hoapham9501/6dofarmrobot/Bản vẽ 3D/Axis2part1_1.step.SLDASM

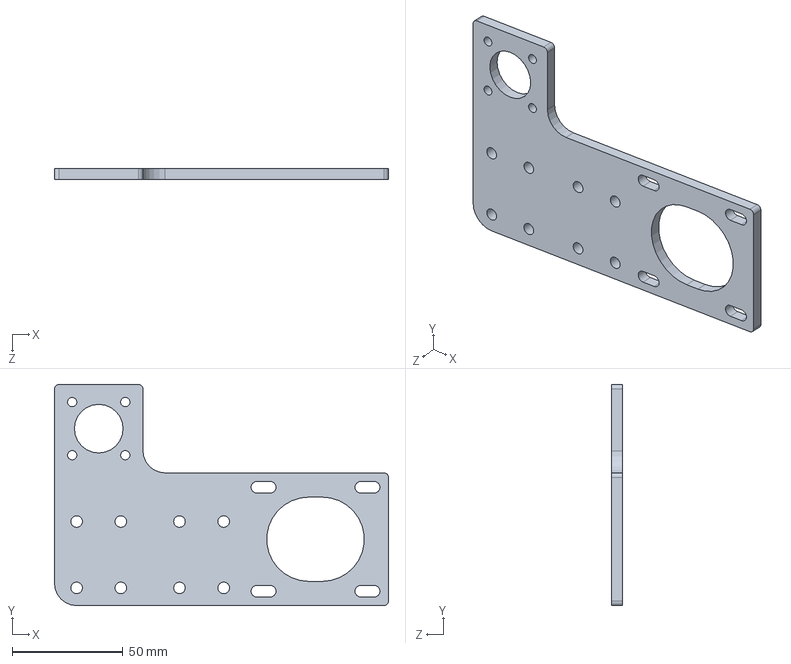
[picture p1: CAD file, 2023-03-05]
Bản vẽ 3D/Axis2part1_1.step.SLDASM
151.0 x 100.0 x 5.00 mm
