hoapham9501/6dofarmrobot/Bản vẽ 3D/4.SLDASM

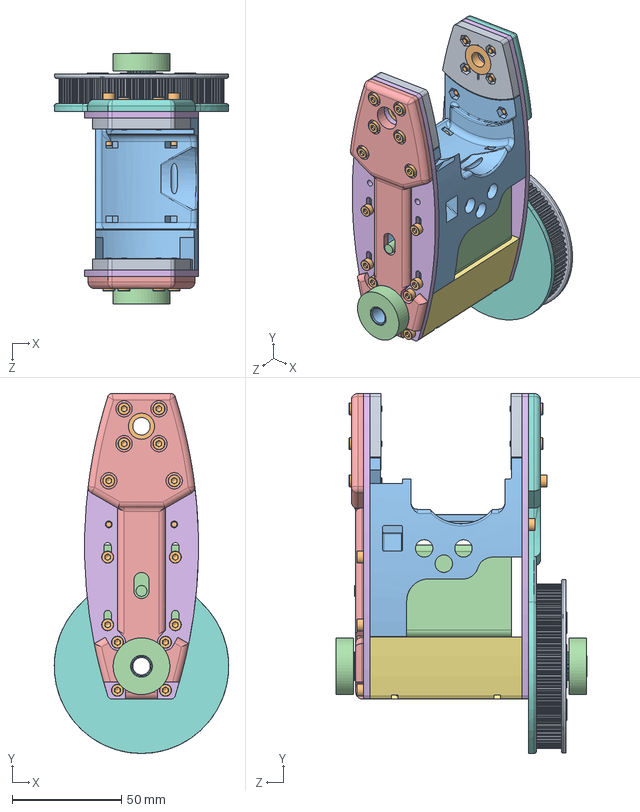
[picture p2: CAD file, 2023-03-05]
Bản vẽ 3D/4.SLDASM
80.0 x 165.0 x 115.0 mm
Axis3bearingHolder.step x 2
Bearing16_8_5_1.step x 2
Axis3part2.step
Nema17_1.step
Axis3cover1.step
Axis3part1_2.step x 2
Axis3part3.step
Axis3cover2.step
Axis2Pulley_1.step
socket head cap screw_iso x 27
Axis2tube.step
Bearing26_10_8_2.step x 2
