hoapham9501/6dofarmrobot/Bản vẽ 3D/Axis3part2.step.SLDPRT

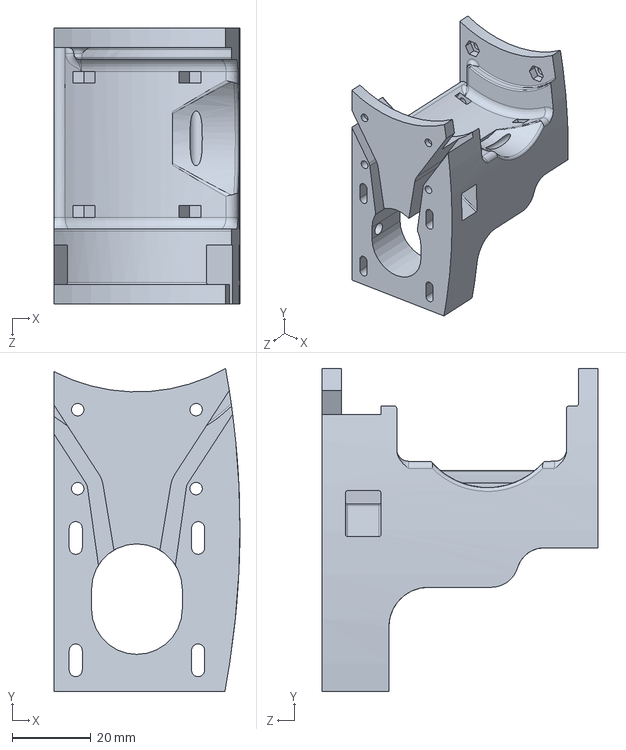
[picture p3: CAD file, 2023-03-05]
Bản vẽ 3D/Axis3part2.step.SLDPRT
47.1 x 81.8 x 69.8 mm
