hoapham9501/6dofarmrobot/Bản vẽ 3D/GT2 20B5.SLDPRT

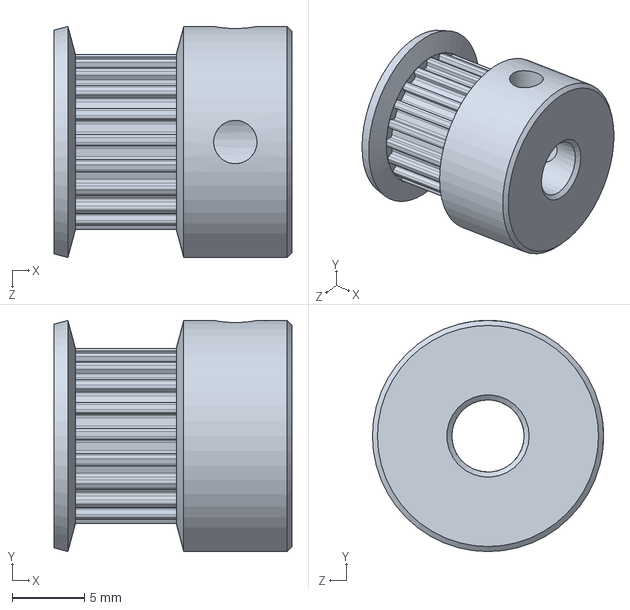
[picture p4: CAD file, 2023-03-05]
Bản vẽ 3D/GT2 20B5.SLDPRT
16.5 x 16.0 x 16.0 mm
