hoapham9501/6dofarmrobot/Bản vẽ 3D/Axis1part2_1.step.SLDPRT

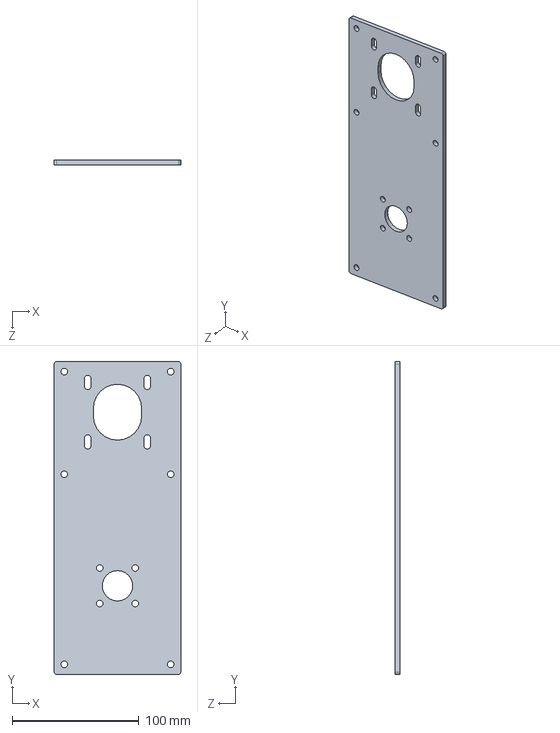
[picture p5: CAD file, 2023-03-05]
Bản vẽ 3D/Axis1part2_1.step.SLDPRT
100.0 x 247.0 x 4.00 mm
