hoapham9501/6dofarmrobot/Bản vẽ 3D/NEMA23(SY57STH56-4004A).SLDPRT

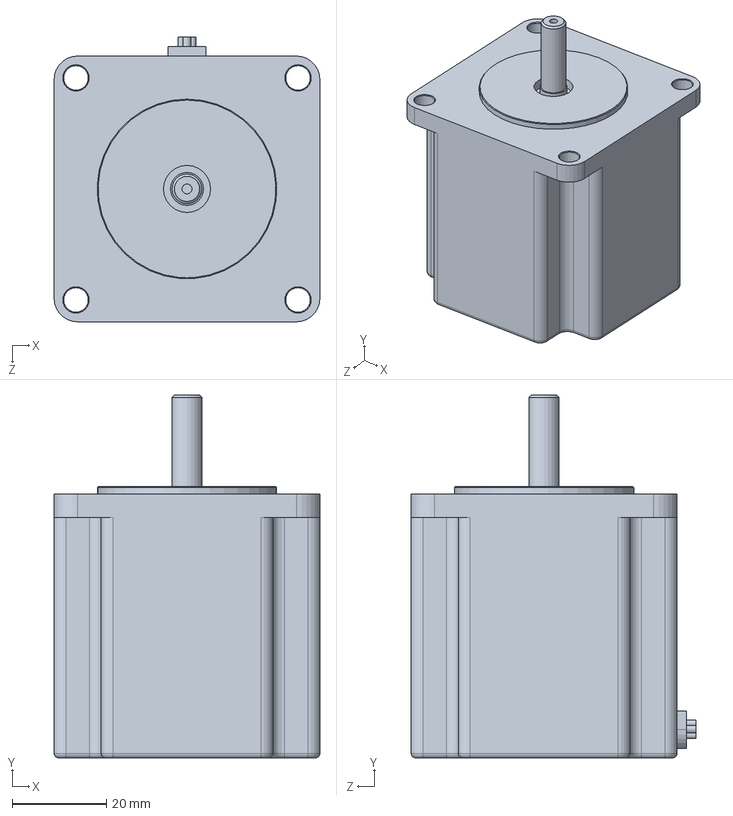
[picture p6: CAD file, 2023-03-05]
Bản vẽ 3D/NEMA23(SY57STH56-4004A).SLDPRT
56.4 x 77.0 x 60.4 mm
