hoapham9501/6dofarmrobot/Bản vẽ 3D/Axis4.step.SLDPRT

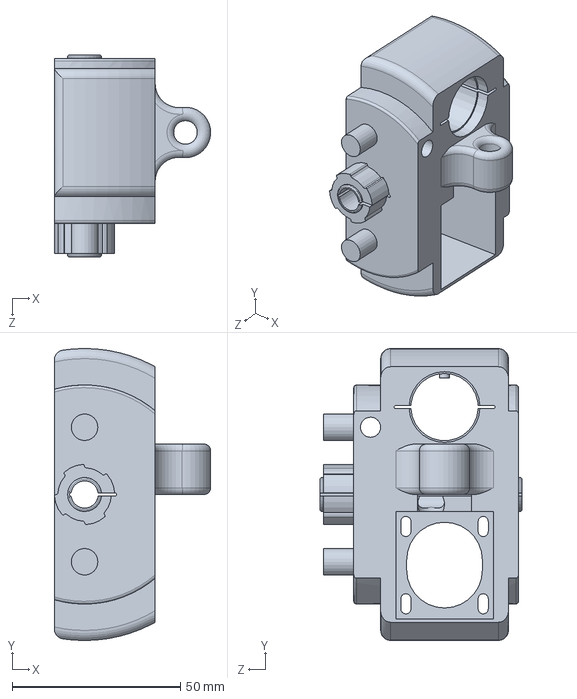
[picture p7: CAD file, 2023-03-05]
Bản vẽ 3D/Axis4.step.SLDPRT
46.5 x 86.8 x 60.0 mm
