hoapham9501/6dofarmrobot/Bản vẽ 3D/HTD3M 20T BORE 8MM.SLDPRT

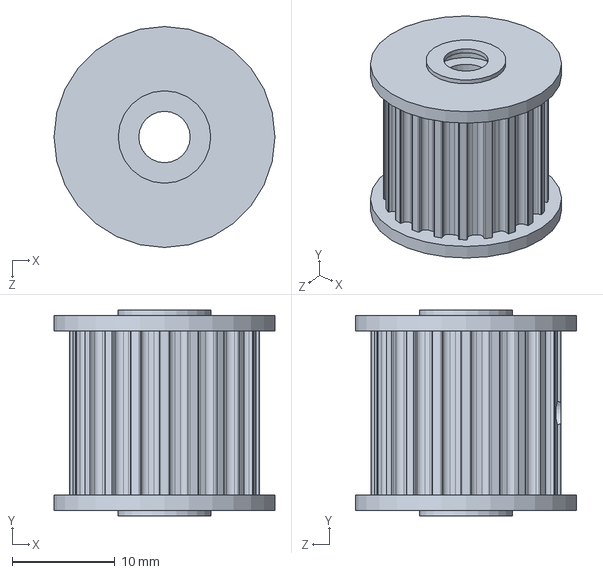
[picture p8: CAD file, 2023-03-05]
Bản vẽ 3D/HTD3M 20T BORE 8MM.SLDPRT
21.5 x 20.0 x 21.5 mm
