hoapham9501/6dofarmrobot/Bản vẽ 3D/Axis5_1.step.SLDPRT

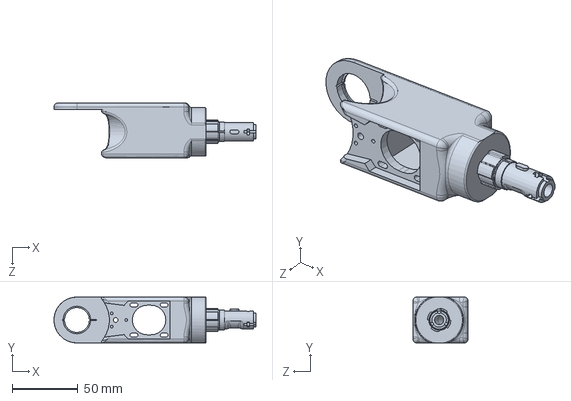
[picture p9: CAD file, 2023-03-05]
Bản vẽ 3D/Axis5_1.step.SLDPRT
154.0 x 35.0 x 42.0 mm
