hoapham9501/6dofarmrobot/Bản vẽ 3D/Axis5Bracket.step.SLDPRT

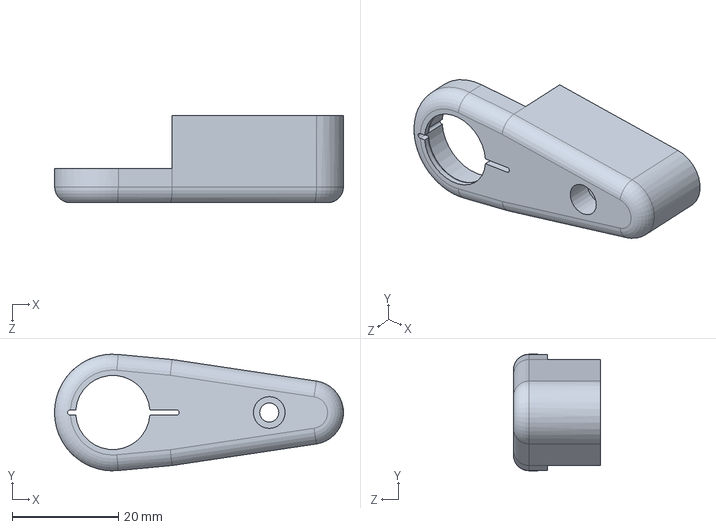
[picture p10: CAD file, 2023-03-05]
Bản vẽ 3D/Axis5Bracket.step.SLDPRT
54.5 x 22.0 x 16.5 mm
