hoapham9501/6dofarmrobot/(list of files, cad)

Other CAD files:
Bản vẽ 3D/Bearing28_12_8_1.step.SLDASM
Bản vẽ 3D/Nema23_1.step.SLDASM
Bản vẽ 3D/Bearing26_10_8_1.step.SLDASM
Bản vẽ 3D/Bearing16_8_5.step-1.SLDASM
Bản vẽ 3D/Nema11_1.step.SLDASM
Bản vẽ 3D/M5standoff_4.step.SLDASM
Bản vẽ 3D/Axis3part1_1.step.SLDASM
Bản vẽ 3D/Nema23.step.SLDASM
Bản vẽ 3D/M5standoff_3.step.SLDASM
Bản vẽ 3D/Bearing28_12_8.step.SLDASM
Bản vẽ 3D/M5standoff_5.step.SLDASM
Bản vẽ 3D/M5standoff_2.step.SLDASM
Bản vẽ 3D/Bearing21_15_4_1.step.SLDASM
Bản vẽ 3D/ThrustBearing28_15_9_1.step.SLDASM
sơ đồ động.dwg
Bản vẽ 3D/Pulley42.step.SLDPRT
Tổng hợp bản vẽ CAD.dwg
Bản vẽ 3D/Axis3part1_2.step.SLDPRT
Bản vẽ 3D/Bearing16_8_5_1.step.SLDPRT
Bản vẽ 3D/Axis1MotorHolderOp.step.SLDPRT
Bản vẽ 3D/Nema23_2.step.SLDPRT
Bản vẽ 3D/Axis2tube.step.SLDPRT
Bản vẽ 3D/Axis5plug.step.SLDPRT
Bản vẽ 3D/Axis2part1_2.step.SLDPRT
Bản vẽ 3D/Axis3tube.step.SLDPRT
Bản vẽ 3D/Pulley56.step.SLDPRT
Bản vẽ 3D/Axis2MotorOpC.step.SLDPRT
Bản vẽ 3D/Pulley100.step.SLDPRT
Bản vẽ 3D/axis6motorHolder_1.step.SLDPRT
Bản vẽ 3D/Axis2part2.step.SLDPRT
Bản vẽ 3D/Axis2Pulley_1.step.SLDPRT
Bản vẽ 3D/M5standoff_6.step.SLDPRT
Bản vẽ 3D/Nema11_2.step.SLDPRT
Bản vẽ 3D/Axis2bearingHC.step.SLDPRT
Bản vẽ 3D/Axis2bearingHolder_1.step.SLDPRT
Bản vẽ 3D/Axis2MotorOp.step.SLDPRT
Bản vẽ 3D/Bearing26_10_8_4.step.SLDPRT
Bản vẽ 3D/Nema17_1.step.SLDPRT
Bản vẽ 3D/Axis1MotorHolder.step.SLDPRT
Bản vẽ 3D/Axis2bearingHolder.step.SLDPRT
Bản vẽ 3D/Axis3cover1.step.SLDPRT
Bản vẽ 3D/Bearing21_15_4_3.step.SLDPRT
Bản vẽ 3D/Bearing26_10_8_2.step.SLDPRT
Bản vẽ 3D/Axis3cover2.step.SLDPRT
Bản vẽ 3D/Axis1Holder.step.SLDPRT
Bản vẽ 3D/Axis1tube.step.SLDPRT
Bản vẽ 3D/Axis3bearingHolder.step.SLDPRT
Bản vẽ 3D/Nema8_1.step.SLDPRT
Bản vẽ 3D/Axis4limit.step.SLDPRT
Bản vẽ 3D/Bearing26_10_8_3.step.SLDPRT
Bản vẽ 3D/Axis1Pulley_1.step.SLDPRT
Bản vẽ 3D/Axis3part3.step.SLDPRT
Bản vẽ 3D/Axis1washer.step.SLDPRT
Bản vẽ 3D/Axis2washer.step.SLDPRT
Bản vẽ 3D/Axis5screwHolder.step.SLDPRT
