hoapham9501/6dofarmrobot/Tổng hợp bản  vẽ.pdf

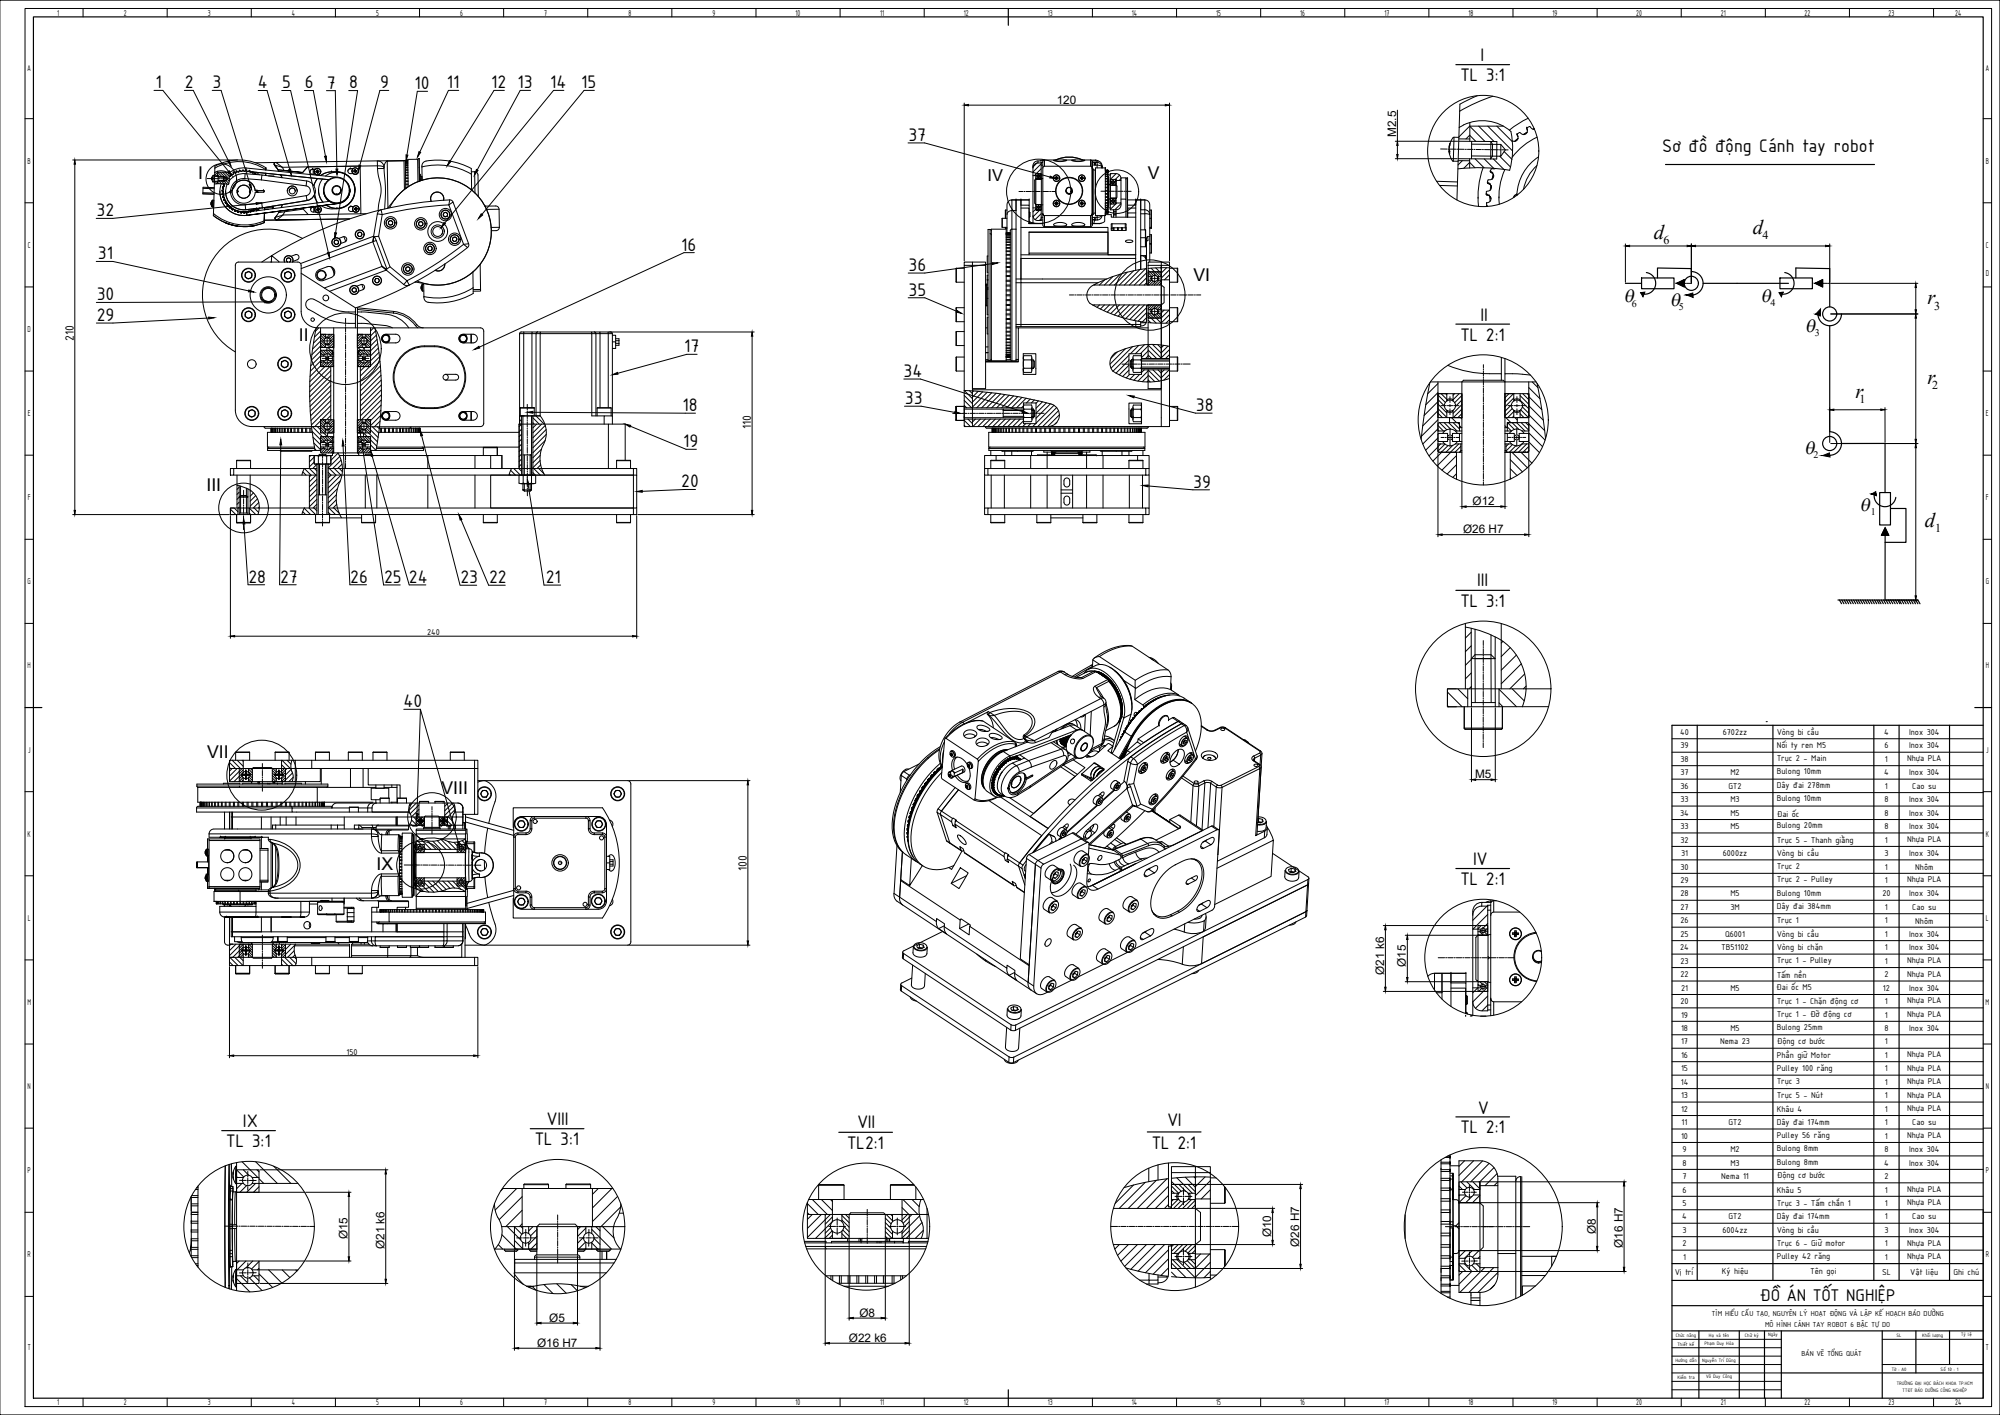
[picture p11: page 1]
24 Thiết kế Hướng dẫn Kiểm tra; Họ và tên Phạm Duy Hòa Nguyễn Trí Dũng Chức năng; Chữ ký; Ngày; BẢN VẼ TỔNG QUÁT; Khối lượng; Số tờ : 1 TRƯỜNG ĐẠI HỌC BÁCH KHOA TP.HCM TTĐT BẢO DƯỠNG CÔNG NGHIỆP 1; A Võ Duy Công Vị trí; Ký hiệu; Tên gọi; Vật liệu; Ghi chú; 1 Dây đai 174mm Pulley 42 răng Trục 6 - Giữ motor Khâu 5 Bulong 8mm Dây đai 174mm Vòng bi cầu Trục 3 Trục 5 - Nút Khâu 4 Pulley 100 răng; 1 Động cơ bước; 8 Trục 1 - Đỡ động cơ; 1 Tấm nền; 2 Trục 1 - Chặn động cơ; 1 Vòng bi chặn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

d6Sơ đồ động Cánh tay robot

Vòng bi cầu | 6 | Nhựa PLA 6702zz Inox 304 40
4 | Inox 304 ĐỒ ÁN TỐT NGHIỆP TÌM HIỂU CẤU TẠO, NGUYÊN LÝ HOẠT ĐỘNG VÀ LẬP KẾ HOẠCH BẢO DƯỠNG MÔ HÌNH CÁNH TAY ROBOT 6 BẬC TỰ DO

Trục 2 - Main | 4 1 Nối ty ren M5 | Inox 304 3839

M5 M3 | Đai ốc M5 Động cơ bước Pulley 56 răng Bulong 10mm Bulong 10mm | 20 12 8 1 M5 1 | Nhựa PLA Nhựa PLA 29 Inox 304 Inox 304 Cao su Nema 23 Inox 304 Nhựa PLA Nhôm Inox 304 TB51102 Inox 304 Q6001 11 Inox 304 Nhôm 36
91012131415161718192021 2324252627283031 3233

2 Bulong 25mm 1

Bulong 8mm | 3 14 | Inox 304 M2

34 | | 1

1 | Nhựa PLA

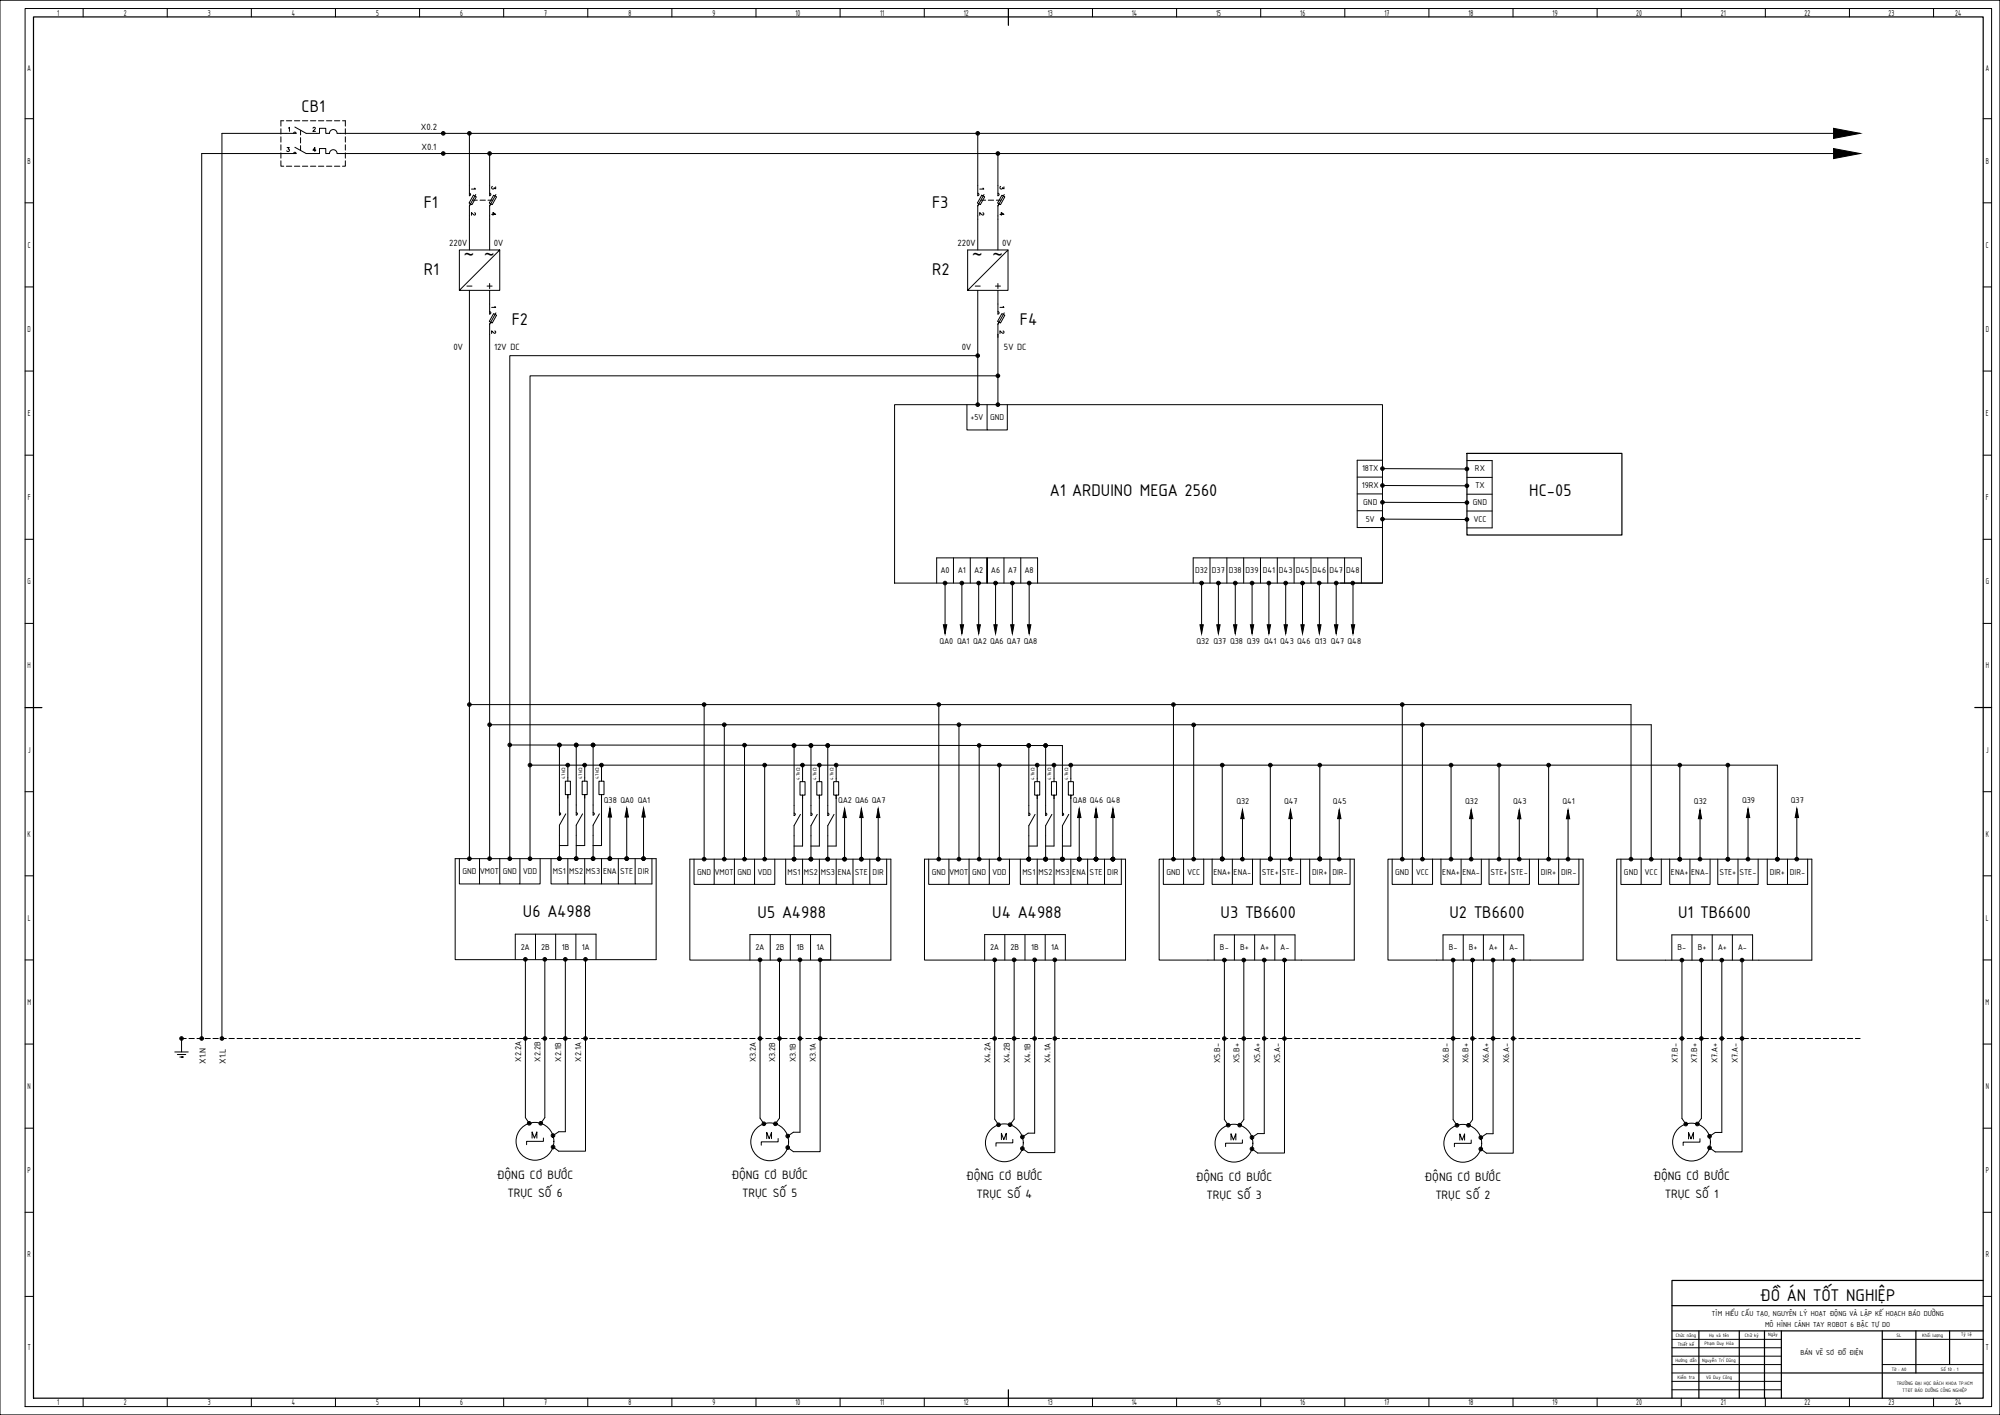
[picture p12: page 2]

X7.A- GND VDD MS1 MS2 MS3 ENA STE DIR U5 A4988 GND VMOT 2A 2B 1B 1A GND VDD MS1 MS2 MS3 ENA STE DIR U4 A4988 GND VMOT 2A 2B 1B 1A ENA+ ENA- U3 TB6600 STE+ STE- DIR+ DIR- B- B+ A+ A- GND VCC QA8 Q46 Q48 CB1 0V 5V DC ~ ~ 220V 0V R1 F1 0V 12V DC

ĐỒ ÁN TỐT NGHIỆP

TÌM HIỂU CẤU TẠO, NGUYÊN LÝ HOẠT ĐỘNG VÀ LẬP KẾ HOẠCH BẢO DƯỠNG

Chức năng | Họ và tên | Chữ ký | Ngày

Phạm Duy Hòa

TRƯỜNG ĐẠI HỌC BÁCH KHOA TP.HCM
TTĐT BẢO DƯỠNG CÔNG NGHIỆP

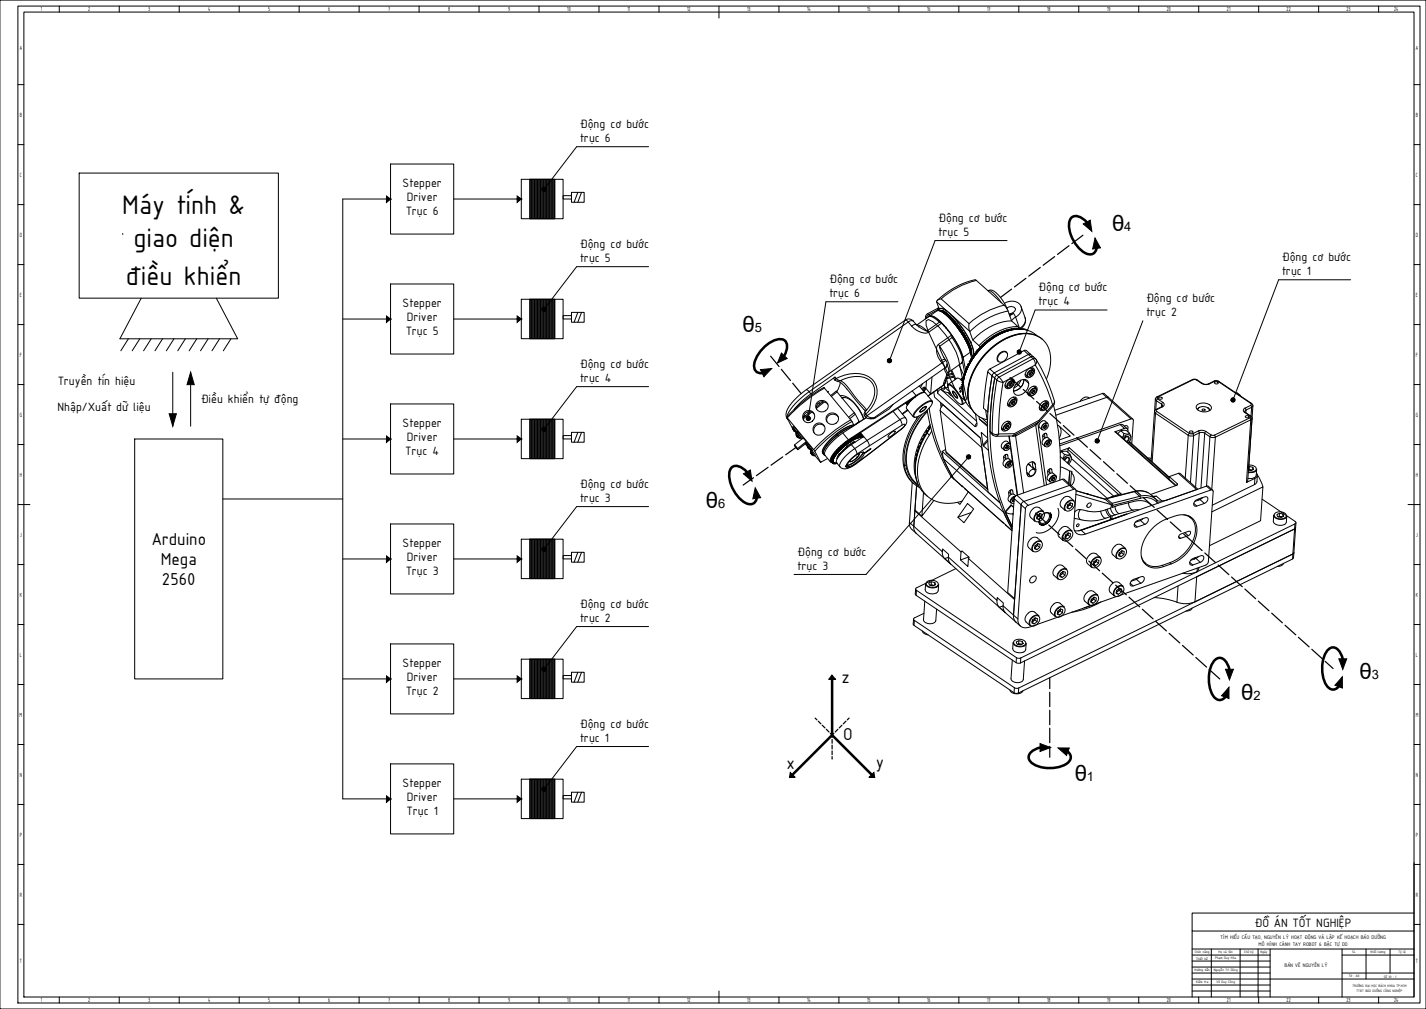
[picture p13: page 3]
24 CDEFGHJKLMNPTRA; BCDEFGHJKLMNPTRA Arduino Mega 2560 Nhập/Xuất dữ liệu; Điều khiển tự động Truyền tín hiệuMáy tính & giao diện điều khiển; θ3 θ4 θ5 θ6 Stepper Driver Trục 6; Động cơ bước trục 6 Stepper Driver Trục 5 Stepper Driver Trục 4 Stepper Driver Trục 3 Stepper Driver Trục 2 Stepper Driver Trục 1; Động cơ bước trục 5 Động cơ bước trục 4; Động cơ bước trục 3 Động cơ bước trục 2 Động cơ bước trục 1; Động cơ bước trục 6; Động cơ bước trục 5; Động cơ bước trục 4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

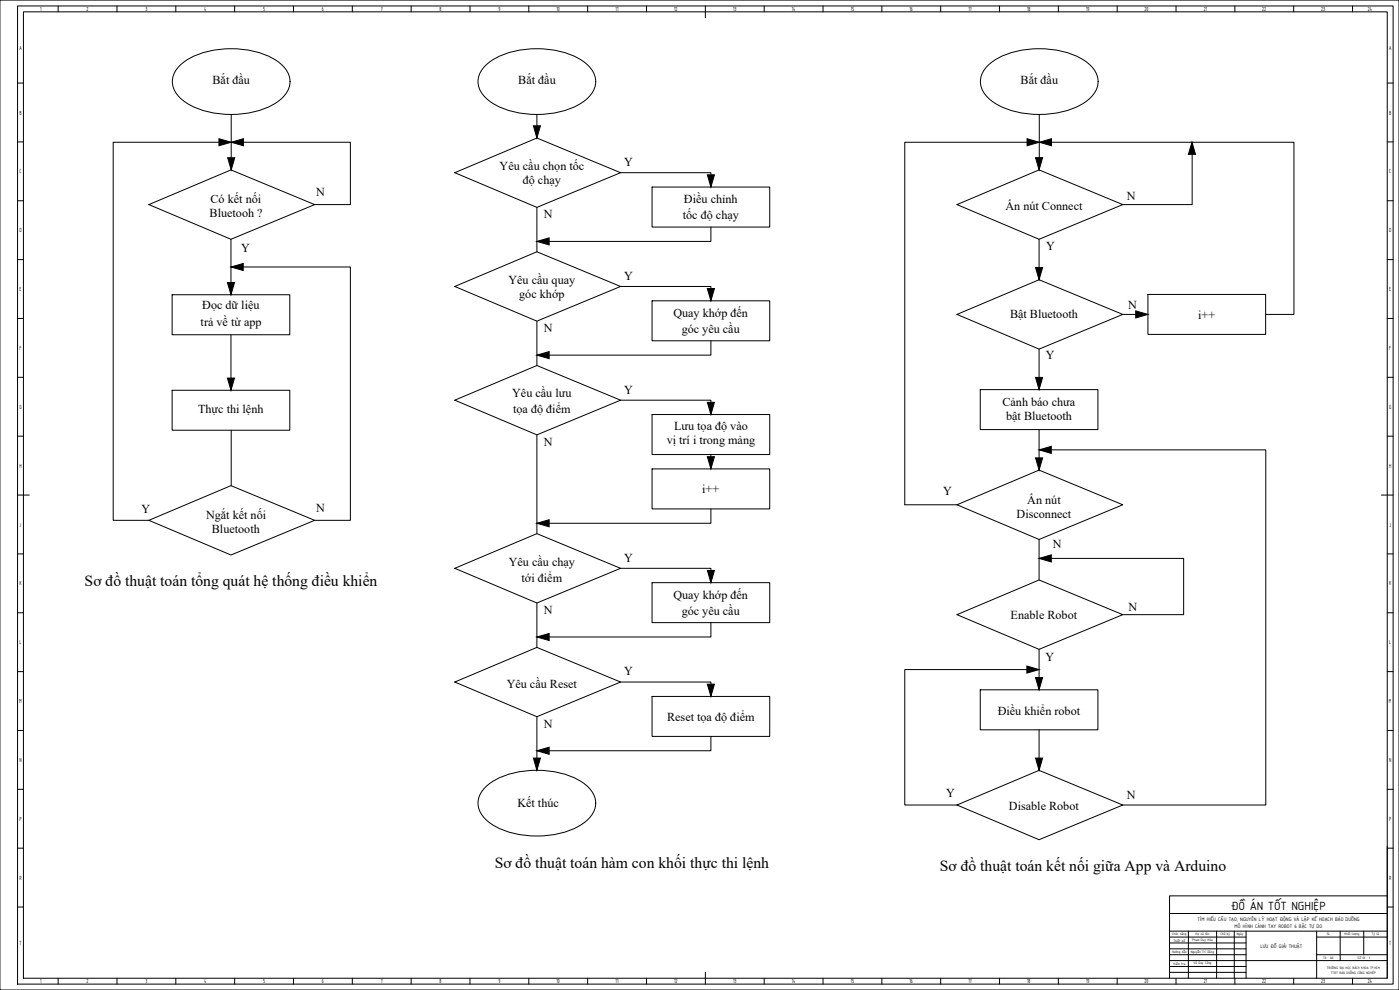
[picture p14: page 4]
24 CDEFGHJKLMNPTRA; BCDEFGHJKLMNPTRA Bắt đầu; Điều chỉnh tốc độ chạy Yêu cầu chọn tốc độ chạy; Quay khớp đến góc yêu cầu Yêu cầu quay góc khớp; Lưu tọa độ vào vị trí i trong mảng Yêu cầu lưu tọa độ điểm; i++ Quay khớp đến góc yêu cầu Yêu cầu chạy tới điểm; Reset tọa độ điểm Yêu cầu Reset Kết thúc; Bắt đầu Ấn nút Connect Bật Bluetooth Cảnh báo chưa bật Bluetooth Ấn nút Disconnect Enable Robot Điều khiển robot; i++ Disable Robot Y N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

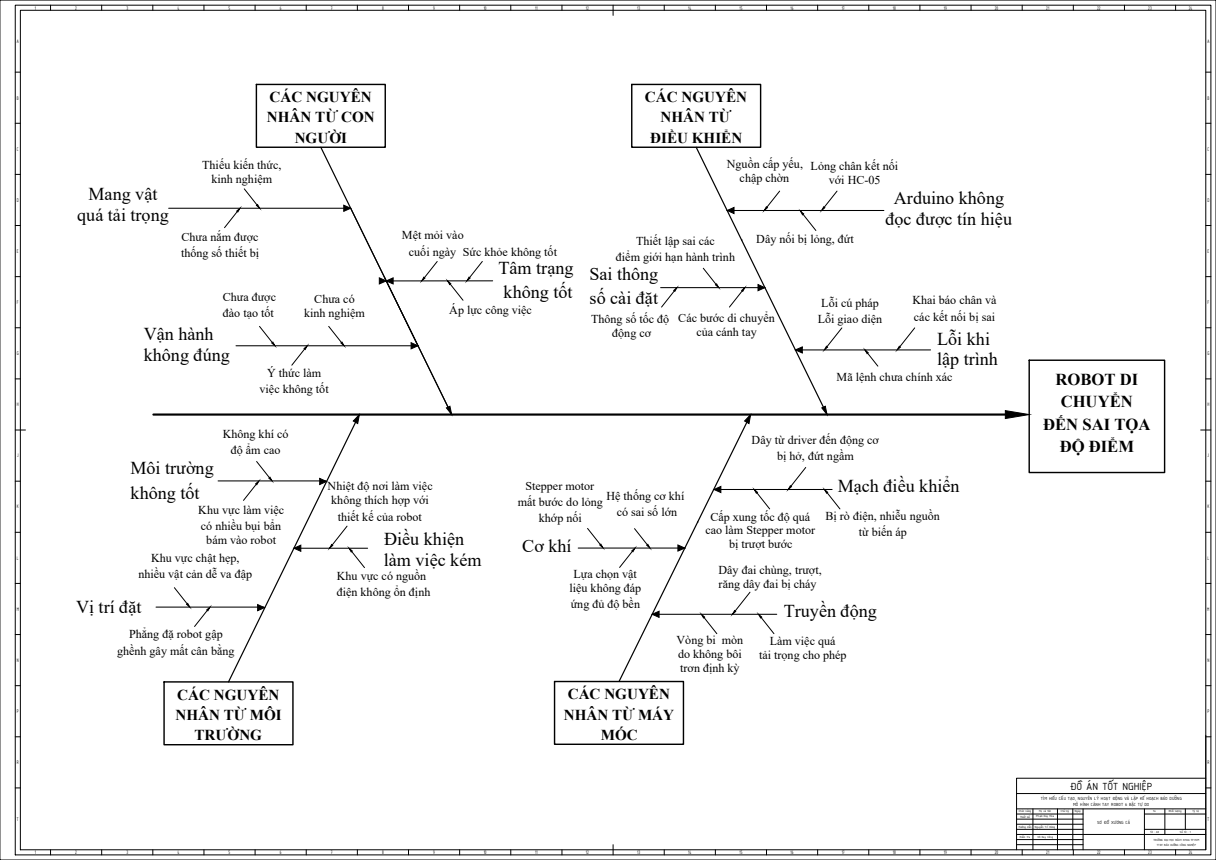
[picture p15: page 5]
24 CDEFGHJKLMNPTRA; BCDEFGHJKLMNPTRA ROBOT DI CHUYỂN ĐẾN SAI TỌA ĐỘ ĐIỂM Sai thông số cài đặt; Arduino không đọc được tín hiệu Lỗi khi lập trình Khai báo chân và các kết nối bị sai Thiết lập sai các điểm giới hạn hành trình Thông số tốc độ động cơ; Mạch điều khiển Dây từ driver đến động cơ bị hở, đứt ngầm Cấp xung tốc độ quá cao làm Stepper motor bị trượt bước Hệ thống cơ khí có sai số lớn Cơ khíLựa chọn vật liệu không đáp ứng đủ độ bền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

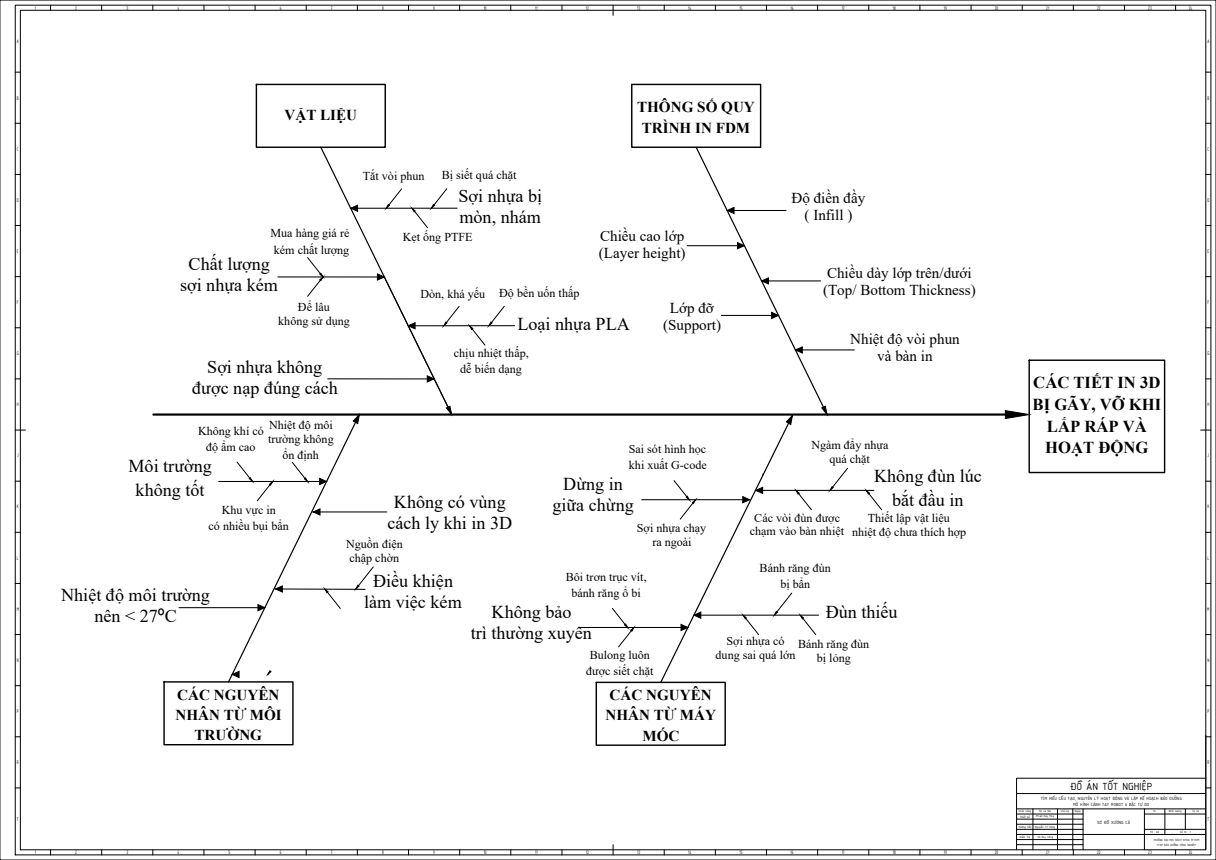
[picture p16: page 6]
24 CDEFGHJKLMNPTRA; BCDEFGHJKLMNPTRA Độ điền đầy ( Infill ); Không đùn lúc bắt đầu in Ngàm đẩy nhựa quá chặt Các vòi đùn được chạm vào bàn nhiệt; Thiết lập vật liệu nhiệt độ chưa thích hợp Đùn thiếu Sợi nhựa có dung sai quá lớn Bánh răng đùn bị lỏng Bánh răng đùn bị bẩn Sợi nhựa bị mòn, nhám Kẹt ống PTFE Môi trường không tốtKhông khí có độ ẩm cao Khu vực in có nhiều bụi bẩn; THÔNG SỐ QUY TRÌNH IN FDM VẬT LIỆU; CÁC NGUYÊN NHÂN TỪ MÁY MÓC CÁC NGUYÊN NHÂN TỪ MÔI TRƯỜNG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

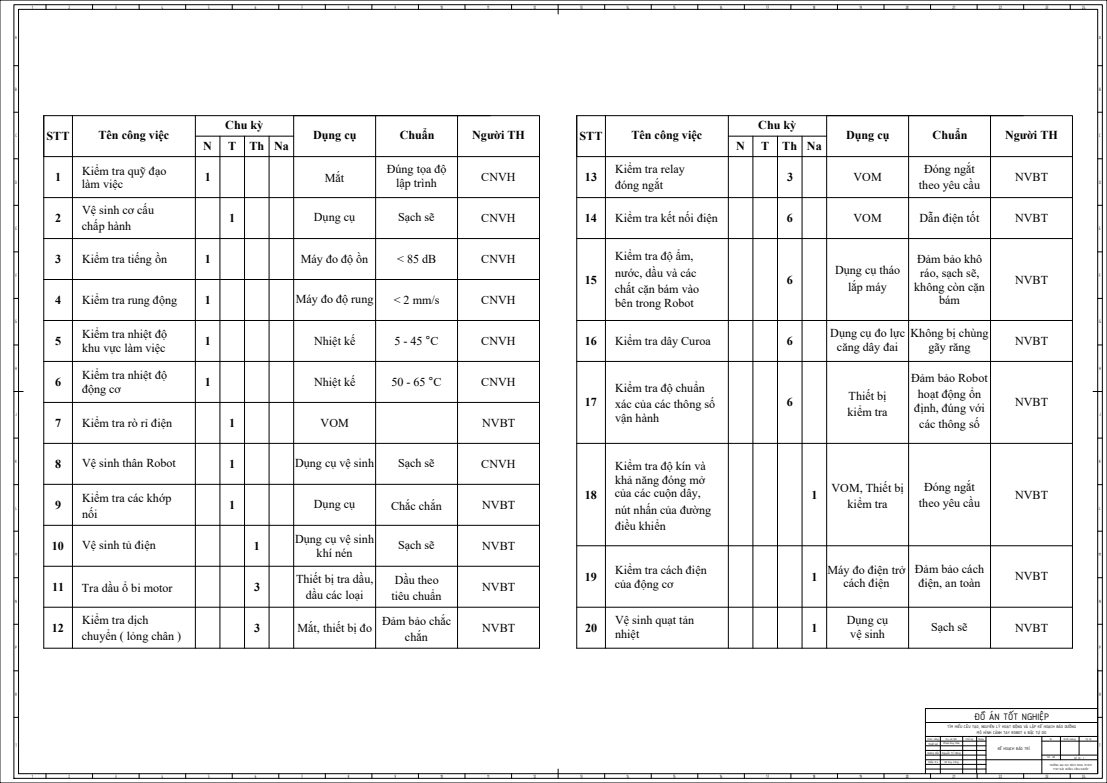
[picture p17: page 7]
24 CDEFGHJKLMNPTRA; BCDEFGHJKLMNPTRA Chu kỳ STT; Tên công việc; Dụng cụ N; Chuẩn; Người TH Kiểm tra quỹ đạo làm việc; Mắt; Đúng tọa độ lập trình; CNVH Vệ sinh cơ cấu chấp hành; Dụng cụ; Sạch sẽ; CNVH 12; Kiểm tra tiếng ồn; Máy đo độ ồn; CNVH 4; Kiểm tra rung động; Máy đo độ rung; CNVH Kiểm tra nhiệt độ khu vực làm việc 5; Nhiệt kế; CNVH Kiểm tra nhiệt độ động cơ 6; CNVH 7; Kiểm tra rò rỉ điện; VOM; NVBT 8; Vệ sinh thân Robot; Dụng cụ vệ sinh; CNVH 1 Kiểm tra các khớp nối 9; Chắc chắn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

B | 1 | 2 | 3 | 4 | 5 | 6 | 7 | 8 | 9 | 10 | 11 | 12 | 13 | 14 | 15 | 16 | 17 | 18 | 19 | 20 | 21 | 22 | 23 | 24 1 | 2 | 3 | 4 | 5 | 6 | 7 | 8 | 9 | 10 | 11 | 12 | 13 | 14 | 15 | 16 | 17 | 18 | 19 | 20 | 21 | 22 | 23 | 24 CDEFGHJKLMNPTRA | BCDEFGHJKLMNPTRA STT | Bộ phận/ Chi tiết | Chức năng Động cơ bước | Biện pháp khắc phục 1 | Phát hiện | Tầm quan trọng F Lỗi/ hư hỏng | Nguyên nhân | G | D | C Hệ thống: Truyền động trục chính các khớp | Ngày Cung cấp chuyển động quay | Động cơ nóng bất thường khi hoạt động | Dòng cung cấp lớn hơn giá trị cho phép | Xúc giác | 1 | 2 | 2 | 4 | Sử dụng VOM và dụng cụ điều chỉnh dòng vào động cơ theo định mức trên Catalouge Động cơ bước bị kẹt trục | Kẹt vòng bị cầu tại gối đỡ trục động cơ | Thị giác | 2 | 2 | 2 | 8 | Thay thế ổ bi của động cơ Mua động cơ dự phòng Động cơ quay chập chờn, không đúng bước | Dây dẫn cấp nguồn vào các pha bị hở, lỏng | Thị giác | 1 | 2 | 2 | 4 | Sử dụng đầu cos phù hợp với dây Siết chặt tại các vị trí tiếp xúc 2 | Dây đai | Truyền chuyển động | Dây đai chùng gây trượt răng | Dãn dây đai sau 1 thời gian sử dụng | Xúc giác Thính giác | 2 | 1 | 2 | 4 | Hiệu chỉnh, căng lại dây đai Gãy răng dây đai | Dây đai hư hỏng sau 1 thời gian sử dụng | Thị giác | 2 | 2 | 2 | 8 | Thay thế dây đai Mua hàng dự phòng 3 | Pulley | Truyền chuyển động | Gãy răng pulley | Vật liệu in PLA kém bền, dễ hư hỏng sau 1 thời gian sử dụng đặt biệt tại các vị trí chịu lực lớn | Thị giác | 2 | Thay thế pulley dự phòng Sử dụng vật liệu có độ bền cao hơn 4 | 2 | 16 Trượt pulley so với trục chính động cơ | Dây đai hư hỏng sau 1 thời gian sử dụng | Thị giác | 2 | 2 | 2 | 8 | Thay thế dây đai Mua hàng dự phòng Kẹt bi vòng bi | Bể bi sau 1 thời gian sử dụng Không được bôi trơn định kì | Thị giác | 2 | 4 | 2 | 16 | Bôi trơn định kỳ Mua hàng dự phòng Thay thế sau 1 khoảng thời gian Bị lỏng cổ trục tại vị trí tiếp xúc với ổ bi | Mòn do ma sát | Thị giác | 3 | 4 | 2 | 24 | Sử dụng trục chính có vật liệu bền hơn Thay thế trục sau 1 khoảng thời gian 4 | Vòng bi | Giảm ma sát lên trục 5 | Trục chính của các khớp | Nhận chuyển động quay Phân tích dạng lỗi, hư hỏng và ảnh hưởng của chúng | Bộ phận/ Chi tiết | Lỗi/ Hư hỏng | Mức độ nghiêm trọng và hành động khắc phục Trục chính | Mòn cổ trục chính | 24 Pulley | Gãy răng | 16 Vòng bi | Kẹt vòng bi | 16 Kẹt trục Động cơ bước | Nóng bất thường Quay chập chờn | 844 Gãy răng Chùng dây đai | 84 Dây đai Pulley | Trượt | 4 | Bảo trì phòng ngừa trực tiếp Bảo trì dự đoán Kiểm tra, bảo trì sữa chửa Đặt hàng linh kiện thay thế dự phòng Thiết kế Hướng dẫn Kiểm tra | Họ và tên Phạm Duy Hòa Nguyễn Trí Dũng Chức năng | Chữ ký | Ngày | BẢNG L'AMDEC | SL | Khối lượng | Tỷ lệ Tờ : A0 | Số tờ : 1 TRƯỜNG ĐẠI HỌC BÁCH KHOA TP.HCM TTĐT BẢO DƯỠNG CÔNG NGHIỆP Võ Duy Công | ĐỒ ÁN TỐT NGHIỆP TÌM HIỂU CẤU TẠO, NGUYÊN LÝ HOẠT ĐỘNG VÀ LẬP KẾ HOẠCH BẢO DƯỠNG MÔ HÌNH CÁNH TAY ROBOT 6 BẬC TỰ DO
